LeThanh666/PE/RTL/ei_pe_controller.sv

`timescale 1ns / 1ps

module ei_pe_controller #(
    parameter NUM_PE = 16
)(
    input  logic sys_clk,
    input  logic rst,
    
    input  logic start,
    output logic done,
    input  logic ready_all,

    input  logic [15:0] reg_max_x,
    input  logic [15:0] reg_max_y,
    input  logic [15:0] reg_max_c,
    input  logic [15:0] reg_max_k,
    input  logic [1:0]  csr_act_mode,
    input  logic [1:0]  csr_pool_mode,
    input  logic        is_pooling_op,      // [CẬP NHẬT: Thêm cờ báo Pure Pooling từ CSR]

    // Giao tiếp BRAM Feature Map
    output logic        fm_mem_read_en,
    output logic [31:0] fm_mem_addr,
    input  logic [255:0] fm_bram_read_data, 
    input  logic        fm_data_valid,      

    // Giao tiếp BRAM Weight
    output logic        w_mem_read_en,
    output logic [31:0] w_mem_addr,
    input  logic        w_data_valid,       

    // Tín hiệu điều khiển & Data tới PE Array
    output logic [NUM_PE-1:0] valid_in,
    output logic [NUM_PE-1:0] acc_clear,
    output logic [NUM_PE-1:0] final_input_channel,
    output logic [1:0]  pool_mode [0:NUM_PE-1],
    output logic [15:0] const_pool [0:NUM_PE-1],
    output logic [1:0]  act_mode [0:NUM_PE-1],
    
    // Data Router Output (Truyền 3x3 Window cho mỗi PE)
    output logic [15:0] pe_fm_data [0:NUM_PE-1][0:2][0:2]
);

    typedef enum logic [3:0] {
        S_IDLE, 
        S_CALC_LAYER, S_WAIT_LAYER, 
        S_WAIT_READY, S_CALC_ADDR, S_WAIT_ADDR, 
        S_FETCH_REQ, S_FETCH_WAIT, S_COMPUTE, S_UPDATE_COUNTERS, S_DONE
    } state_t;

    state_t current_state, next_state;

    logic [15:0] count_x, count_y, count_ic, count_oc;
    logic [3:0]  fetch_cnt; 

    logic [15:0] in_max_x;
    logic [15:0] in_max_y;
    assign in_max_x = reg_max_x;
    assign in_max_y = reg_max_y;

    // [CẬP NHẬT: Tính toán Stride và bước nhảy tĩnh]
    logic [15:0] current_stride;
    logic [15:0] x_step;
    
    // Nếu pool_mode == 00 (Conv thường) -> Stride = 1. Ngược lại -> Stride = 2
    assign current_stride = (csr_pool_mode == 2'b00) ? 16'd1 : 16'd2;
    // Số pixel X quét được trong 1 lần = 16 PE * Stride (Stride 1 nhảy 16, Stride 2 nhảy 32)
    assign x_step         = NUM_PE * current_stride; 

    // =================================================================
    // 1. MODULE TÍNH TOÁN ĐỊA CHỈ
    // =================================================================
    logic mult_en = 1'b1;
    logic valid_in_layer, valid_out_layer;
    logic [31:0] out_layer_size;
    logic [31:0] reg_fm_layer_size; 

    ei_unsigned_multiple_16bit mult_layer (
        .sys_clk(sys_clk), .rst(rst), .en(mult_en),
        .valid_in(valid_in_layer), .a_in(in_max_x), .b_in(in_max_y),
        .valid_out(valid_out_layer), .c_out(out_layer_size)
    );

    logic valid_in_addr, valid_out_w, valid_out_y, valid_out_ic;
    logic [31:0] out_w_offset, out_y_offset, out_ic_offset;
    
    ei_unsigned_multiple_16bit mult_w (
        .sys_clk(sys_clk), .rst(rst), .en(mult_en),
        .valid_in(valid_in_addr), .a_in(count_oc), .b_in(reg_max_c),
        .valid_out(valid_out_w), .c_out(out_w_offset)
    );

    ei_unsigned_multiple_16bit mult_y (
        .sys_clk(sys_clk), .rst(rst), .en(mult_en),
        .valid_in(valid_in_addr), .a_in(count_y), .b_in(in_max_x),
        .valid_out(valid_out_y), .c_out(out_y_offset)
    );

    ei_unsigned_multiple_16bit mult_ic (
        .sys_clk(sys_clk), .rst(rst), .en(mult_en),
        .valid_in(valid_in_addr), .a_in(count_ic), .b_in(reg_fm_layer_size[15:0]), 
        .valid_out(valid_out_ic), .c_out(out_ic_offset)
    );

    logic [31:0] base_w_addr;
    logic [31:0] current_fm_offset;

    // =================================================================
    // 2. DATA ROUTER & WINDOW BUFFER
    // =================================================================
    logic [15:0] window_left  [0:2][0:15];
    logic [15:0] window_right [0:2][0:15];
    logic [15:0] window_full  [0:2][0:31];
    
    always_comb begin
        for (int r = 0; r < 3; r++) begin
            for (int c = 0; c < 16; c++) begin
                window_full[r][c]    = window_left[r][c];
                window_full[r][c+16] = window_right[r][c];
            end
        end
    end

    always_comb begin
        for (int i = 0; i < NUM_PE; i++) begin
            for (int r = 0; r < 3; r++) begin
                if (csr_pool_mode == 2'b00) begin 
                    pe_fm_data[i][r][0] = window_full[r][i];
                    pe_fm_data[i][r][1] = window_full[r][i+1];
                    pe_fm_data[i][r][2] = window_full[r][i+2];
                end else begin 
                    pe_fm_data[i][r][0] = window_full[r][i*2];
                    pe_fm_data[i][r][1] = window_full[r][i*2+1];
                    pe_fm_data[i][r][2] = 16'd0; 
                end
            end
        end
    end

    logic [15:0] fm_bram_unpacked [0:15];
    always_comb begin
        for (int i = 0; i < 16; i++) begin
            fm_bram_unpacked[i] = fm_bram_read_data[i*16 +: 16];
        end
    end

    // =================================================================
    // 3. FSM LOGIC & DATAPATH
    // =================================================================
    always_ff @(posedge sys_clk) begin
        if (rst) current_state <= S_IDLE;
        else     current_state <= next_state;
    end

    always_comb begin
        next_state = current_state;
        case (current_state)
            S_IDLE:            if (start) next_state = S_CALC_LAYER;
            S_CALC_LAYER:      next_state = S_WAIT_LAYER;
            S_WAIT_LAYER:      if (valid_out_layer) next_state = S_WAIT_READY;
            
            S_WAIT_READY:      if (ready_all) next_state = S_CALC_ADDR;
            S_CALC_ADDR:       next_state = S_WAIT_ADDR;
            S_WAIT_ADDR:       if (valid_out_w) next_state = S_FETCH_REQ; 
            S_FETCH_REQ:       next_state = S_FETCH_WAIT;
            
            S_FETCH_WAIT: begin
                // [CẬP NHẬT: Nếu là Pooling thì bỏ qua w_data_valid, tự động báo True]
                if ((fetch_cnt == 0 && fm_data_valid && (is_pooling_op || w_data_valid)) || 
                    (fetch_cnt > 0 && fm_data_valid)) begin
                    
                    if (fetch_cnt == 5) next_state = S_COMPUTE; 
                    else                next_state = S_FETCH_REQ; 
                end else begin
                    next_state = S_FETCH_WAIT; 
                end
            end
            
            S_COMPUTE:         next_state = S_UPDATE_COUNTERS;
            
            S_UPDATE_COUNTERS: begin
                // [CẬP NHẬT: Sửa lại điều kiện Done dựa trên Stride]
                if (count_ic == reg_max_c - 1 && 
                   (count_x + x_step) >= reg_max_x && 
                    count_y >= (reg_max_y - current_stride) && 
                    count_oc == reg_max_k - 1)
                    next_state = S_DONE;
                else
                    next_state = S_WAIT_READY; 
            end
            
            S_DONE:            next_state = S_IDLE;
            default:           next_state = S_IDLE;
        endcase
    end

    always_ff @(posedge sys_clk) begin
        if (rst) begin
            count_x <= 0; count_y <= 0; count_ic <= 0; count_oc <= 0; done <= 0;
            valid_in <= '0; acc_clear <= '0; final_input_channel <= '0;
            fm_mem_read_en <= 0; w_mem_read_en <= 0; fm_mem_addr <= 0; w_mem_addr <= 0;
            valid_in_layer <= 0; valid_in_addr <= 0; reg_fm_layer_size <= 0;
            base_w_addr <= 0; fetch_cnt <= 0; current_fm_offset <= 0;
            for (int r=0; r<3; r++) begin
                for (int c=0; c<16; c++) begin
                    window_left[r][c] <= 16'd0;
                    window_right[r][c] <= 16'd0;
                end
            end
        end else begin
            valid_in <= '0; acc_clear <= '0; final_input_channel <= '0;
            valid_in_layer <= 0; valid_in_addr <= 0;

            case (current_state)
                S_IDLE: begin
                    count_x <= 0; count_y <= 0; count_ic <= 0; count_oc <= 0; fetch_cnt <= 0; done <= 0;
                end
                
                S_CALC_LAYER: valid_in_layer <= 1'b1;
                S_WAIT_LAYER: if (valid_out_layer) reg_fm_layer_size <= out_layer_size;
                S_WAIT_READY: fetch_cnt <= 0;
                S_CALC_ADDR:  valid_in_addr <= 1'b1;
                
                S_WAIT_ADDR: begin
                    if (valid_out_w) begin
                        base_w_addr       <= out_w_offset + count_ic;
                        current_fm_offset <= out_ic_offset + out_y_offset + count_x; 
                    end
                end

                S_FETCH_REQ: begin
                    fm_mem_read_en <= 1'b1;

                    case (fetch_cnt)
                        0: fm_mem_addr <= (current_fm_offset + 0 * in_max_x) << 1;           
                        1: fm_mem_addr <= (current_fm_offset + 0 * in_max_x + 16) << 1;      
                        2: fm_mem_addr <= (current_fm_offset + 1 * in_max_x) << 1;           
                        3: fm_mem_addr <= (current_fm_offset + 1 * in_max_x + 16) << 1;      
                        4: fm_mem_addr <= (current_fm_offset + 2 * in_max_x) << 1;           
                        5: fm_mem_addr <= (current_fm_offset + 2 * in_max_x + 16) << 1;      
                    endcase

                    if (fetch_cnt == 0) begin
                        // [CẬP NHẬT: Chỉ cấp phát yêu cầu đọc BRAM Weight nếu không phải Pooling]
                        if (!is_pooling_op) begin
                            w_mem_read_en <= 1'b1;
                            w_mem_addr    <= base_w_addr; 
                        end else begin
                            w_mem_read_en <= 1'b0;
                        end
                    end
                end

                S_FETCH_WAIT: begin
                    fm_mem_read_en <= 1'b0;
                    w_mem_read_en  <= 1'b0;

                    if ((fetch_cnt == 0 && fm_data_valid && (is_pooling_op || w_data_valid)) || 
                        (fetch_cnt > 0 && fm_data_valid)) begin
                        
                        case (fetch_cnt)
                            0: window_left[0]  <= fm_bram_unpacked;
                            1: window_right[0] <= fm_bram_unpacked;
                            2: window_left[1]  <= fm_bram_unpacked;
                            3: window_right[1] <= fm_bram_unpacked;
                            4: window_left[2]  <= fm_bram_unpacked;
                            5: window_right[2] <= fm_bram_unpacked;
                        endcase
                        
                        fetch_cnt <= fetch_cnt + 1;
                    end
                end
                
                S_COMPUTE: begin
                    for (int i = 0; i < NUM_PE; i++) begin
                        // [CẬP NHẬT: Kiểm tra tọa độ X thực tế của từng PE dựa trên Stride]
                        if ((count_x + i * current_stride) < reg_max_x) begin
                            valid_in[i] <= 1'b1;
                            
                            if (count_ic == 0) acc_clear[i] <= 1'b1;
                            else acc_clear[i] <= 1'b0;
                            
                            if (count_ic == reg_max_c - 1) final_input_channel[i] <= 1'b1;
                            else final_input_channel[i] <= 1'b0;
                            
                        end else begin
                            valid_in[i] <= 1'b0;
                            acc_clear[i] <= 1'b0;
                            final_input_channel[i] <= 1'b0;
                        end
                        
                        act_mode[i]   <= csr_act_mode;
                        pool_mode[i]  <= csr_pool_mode;
                        const_pool[i] <= 16'd0;
                    end
                end
                
                S_UPDATE_COUNTERS: begin
                    fetch_cnt <= 0;
                    if (count_ic == reg_max_c - 1) begin
                        count_ic <= 0; 
                        
                        // [CẬP NHẬT: Cộng thêm khối theo Stride ngang]
                        if (count_x + x_step >= reg_max_x) begin 
                            count_x <= 0; 
                            
                            // [CẬP NHẬT: Nhảy hàng theo Stride dọc]
                            if (count_y >= reg_max_y - current_stride) begin 
                                count_y <= 0; 
                                if (count_oc != reg_max_k - 1) count_oc <= count_oc + 1;
                            end else begin
                                count_y <= count_y + current_stride; 
                            end
                        end else begin
                            count_x <= count_x + x_step; 
                        end
                        
                    end else begin
                        count_ic <= count_ic + 1; 
                    end
                end
                
                S_DONE: done <= 1;
            endcase
        end
    end

    //////
    always @(posedge sys_clk) begin
        if(fm_data_valid) begin
            // $write không tự động xuống dòng như $display
            $write("[controller] Addr %h: ", fm_mem_addr);
            
            // Quét từ phần tử 0 đến 15 (đúng thứ tự địa chỉ tăng dần)
            for (int i = 0; i < 16; i++) begin
                // In 16 bit (2 byte) và nối thêm 1 khoảng trắng " "
                $write("%04h ", fm_bram_read_data[i*16 +: 16]);
            end
            
            // In xong 16 phần tử thì xuống dòng
            $write("\n");
        end
    end

endmodule
